Flo69au/capteur-temp-rature-scd40_zigbee/(commit log)

2026-10-29 Ajout du scanner I2C de diagnostic
2026-10-29 Ajout du workflow de release OTA
2026-10-29 Ajout du firmware Arduino (XIAO ESP32-C6 + SCD40, Zigbee, OTA)
2026-10-29 README : retrait de l'image de l'ancien projet
2026-10-29 Workflow OTA : accepte les tags créés depuis l'interface Releases
2026-10-29 Envoi forcé des mesures toutes les 30 s (report() explicite)
2026-11-01 README : config OTA Z2M (vérification automatique, blocs de 50 octets)
2026-11-07 README : tags de version v1.0, v1.1...
2026-11-08 v1.2 : flash LED à chaque envoi de données (1 s si échec)
2026-11-08 README : flash LED à chaque envoi
